TheCompWiz/SkyTime-ESP32-P4-NTP-SVR/SkyTime_Version_1.0/artwork/background.jpg

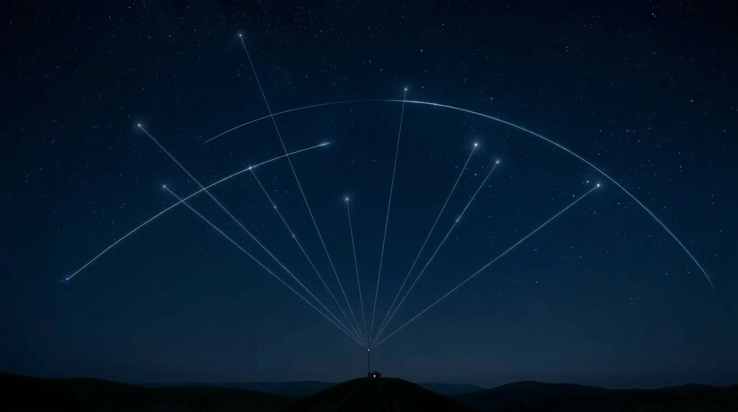
SkyTime_Version_1.0/artwork/background.jpg
