TheCompWiz/SkyTime-ESP32-P4-NTP-SVR/SkyTime_Version_1.0/system_pictures/SkyTime_Case_TopDown.webp

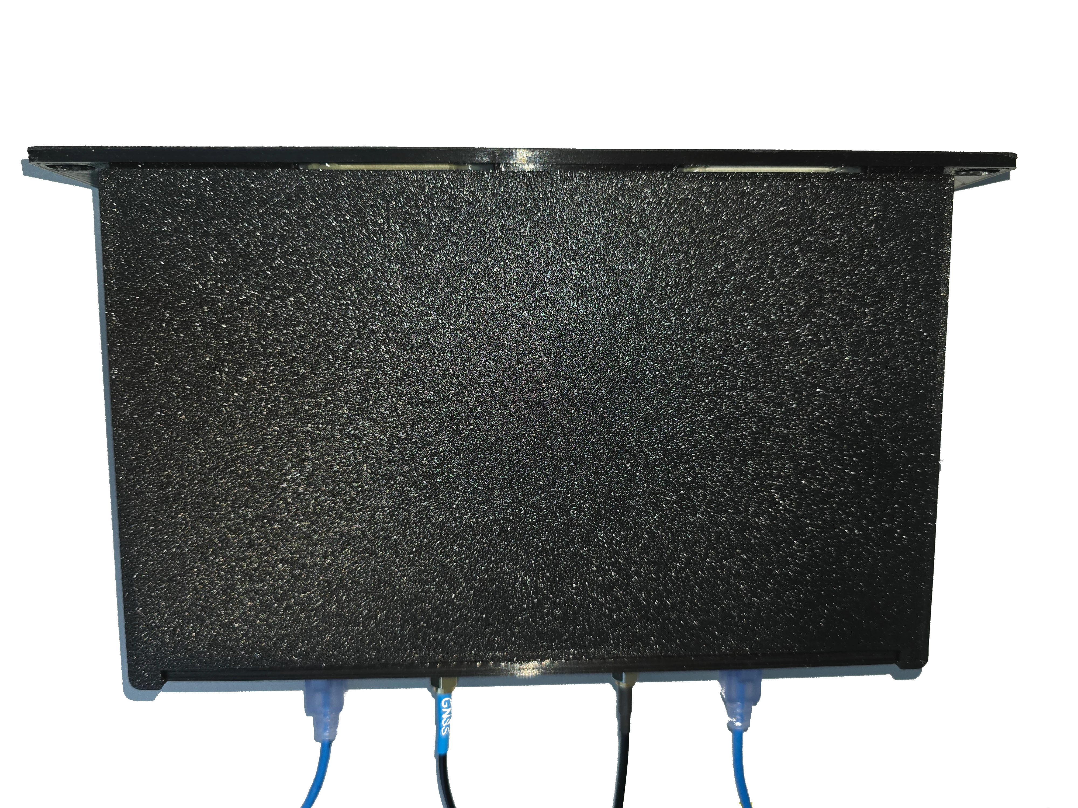
SkyTime_Version_1.0/system_pictures/SkyTime_Case_TopDown.webp
