TheCompWiz/SkyTime-ESP32-P4-NTP-SVR/SkyTime_Version_1.0/hardware/docs/STL_ATTRIBUTION.md

# STL Files & Attributions

The SkyTime Version 1.0 rack enclosure is based on heavily modified designs derived from the work of the original creators listed below.

## Original Designs

### 10-inch Rack Shelf Drawer

Original Designer: Diew

Original Model: 10-inch Rack Shelf Drawers

License: Creative Commons Attribution-NonCommercial-ShareAlike 4.0 International (CC BY-NC-SA 4.0)

License URL: https://creativecommons.org/licenses/by-nc-sa/4.0/

Original Model URL: https://makerworld.com/en/models/1845503-10-inch-rack-shelf-drawers?from=search#profileId-2448316

### Waveshare ESP32-P4 ETH PoE Case

Original Designer: Fabrion365

Original Model: Waveshare ESP32-P4 ETH PoE Case

Original Model URL: https://makerworld.com/en/models/2019211-waveshare-esp32-p4-eth-poe-case#profileId-2175894

Note: Confirm and preserve the original license selected by Fabrion365 before redistributing modified STL files.

## SkyTime Modifications

The STL files distributed with SkyTime Version 1.0 have been substantially modified to support:

- Dual SkyTime installation
- 10-inch rack mounting
- Front panel display visibility
- Front panel recessed button access
- Rear Ethernet access
- Rear GPS antenna access
- Rear USB access
- Waveshare ESP32-P4 ETH PoE mounting retainers
- GPS module retainers
- Integrated top cover

All SkyTime-specific modifications were performed by RPMof78.

## Printing Information

Validated Printer: Creality Ender 3 MAX

Material: PLA

## Attribution Requirement

The original designers retain copyright to their respective works.

Any redistribution of the modified STL files must preserve attribution to the original designers and comply with the licensing requirements associated with the original models.
