TheCompWiz/SkyTime-ESP32-P4-NTP-SVR/SkyTime_Version_1.0/hardware/stl/SkyTime_Drawer_ESP32P4_Retainer.stl

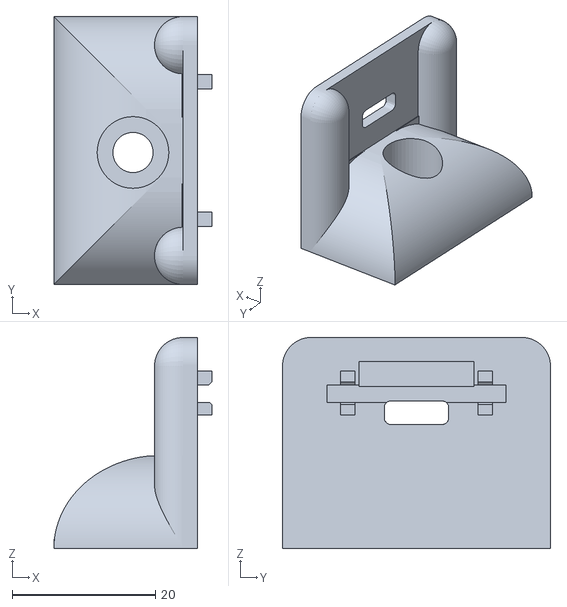
[picture p5: CAD file, 2026-06-18]
SkyTime_Version_1.0/hardware/stl/SkyTime_Drawer_ESP32P4_Retainer.stl
22.0 x 37.4 x 29.5
