TheCompWiz/SkyTime-ESP32-P4-NTP-SVR/SkyTime_Version_1.0/hardware/stl/SkyTime_2X_Drawer_10inch.stl

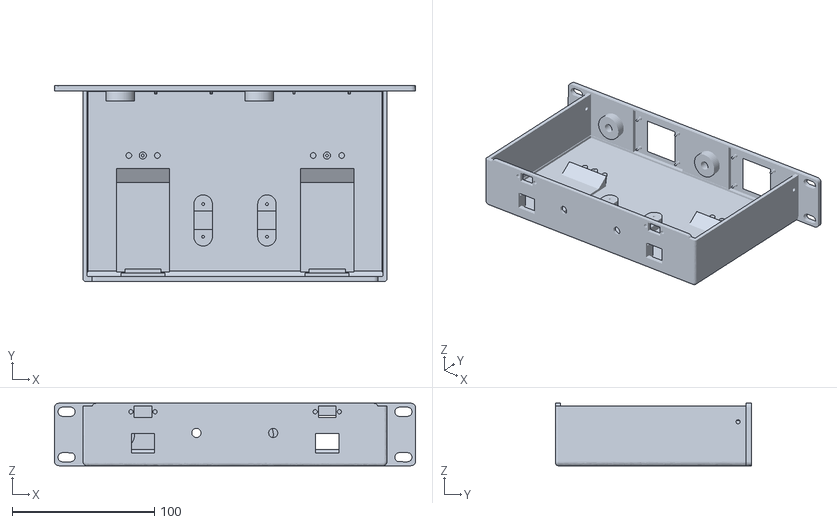
[picture p6: CAD file, 2026-06-18]
SkyTime_Version_1.0/hardware/stl/SkyTime_2X_Drawer_10inch.stl
254.0 x 138.0 x 44.0
