TheCompWiz/SkyTime-ESP32-P4-NTP-SVR/SkyTime_Version_1.0/hardware/stl/SkyTime_Drawer_GPS_Retainer.stl

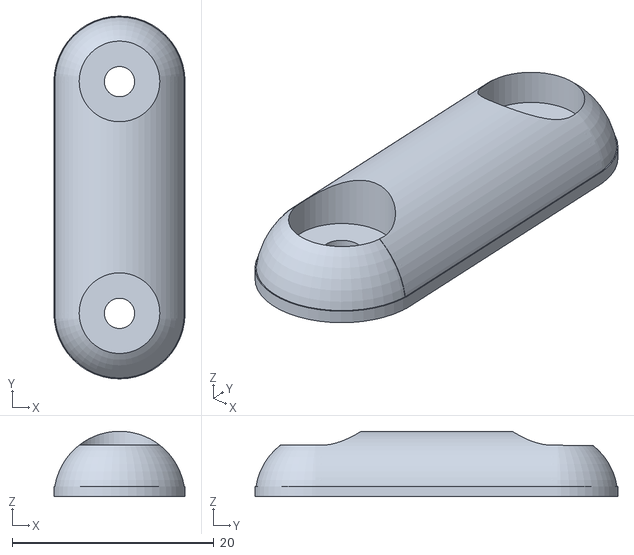
[picture p7: CAD file, 2026-06-18]
SkyTime_Version_1.0/hardware/stl/SkyTime_Drawer_GPS_Retainer.stl
13.0 x 36.0 x 6.50
