TheCompWiz/SkyTime-ESP32-P4-NTP-SVR/SkyTime_Version_1.0/hardware/stl/SkyTime_Drawer_TopCover.stl

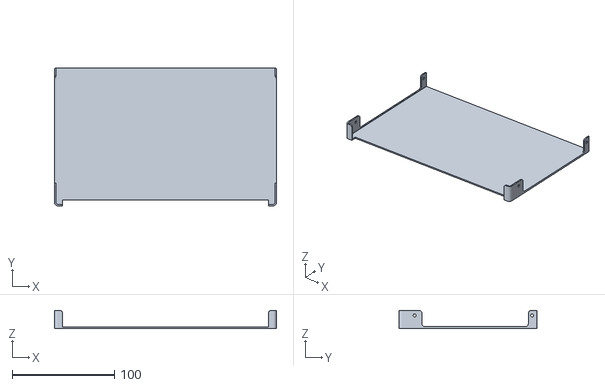
[picture p8: CAD file, 2026-06-18]
SkyTime_Version_1.0/hardware/stl/SkyTime_Drawer_TopCover.stl
217.2 x 134.6 x 18.0
